NOPLAB/burgerchan/mechanism/clamp.step

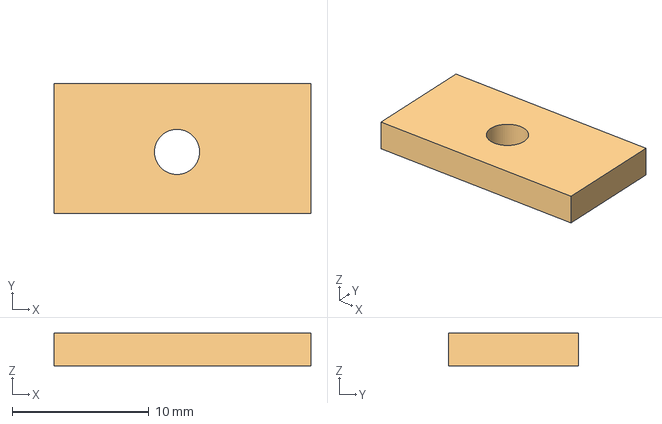
[picture p2: CAD file, 2026-10-23]
mechanism/clamp.step
18.8 x 9.50 x 2.40 mm
