NOPLAB/burgerchan/mechanism/reference/left_tire.stl

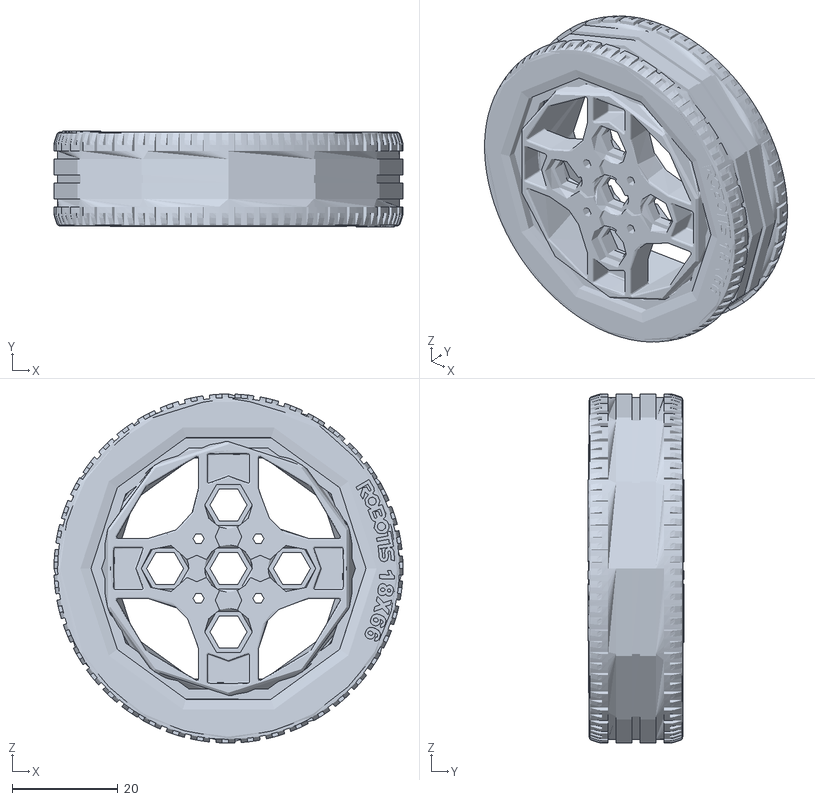
[picture p3: CAD file, 2026-10-23]
mechanism/reference/left_tire.stl
66.0 x 18.2 x 66.0
