NOPLAB/burgerchan/mechanism/carrier.step

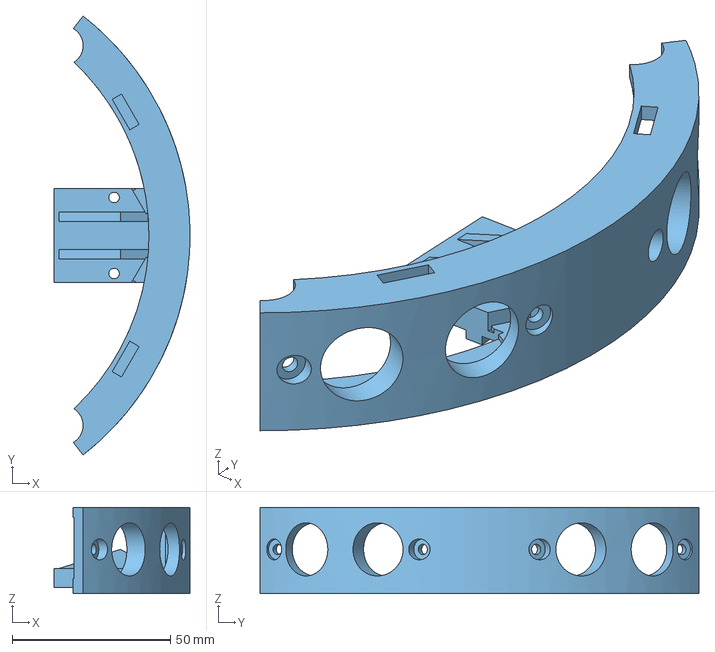
[picture p4: CAD file, 2026-10-23]
mechanism/carrier.step
43.0 x 138.7 x 27.3 mm
