NOPLAB/burgerchan/mechanism/reference/burger_base.stl

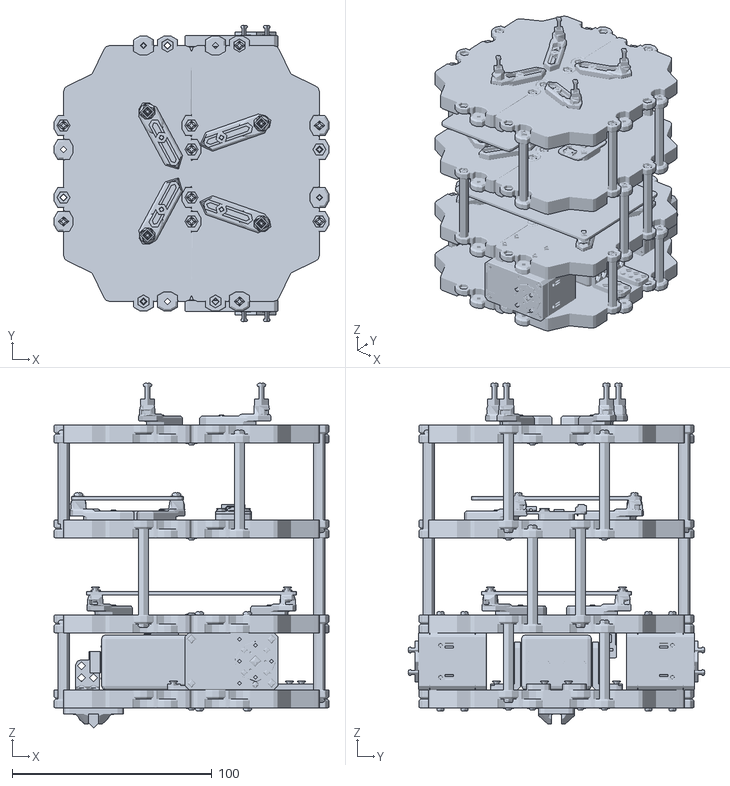
[picture p5: CAD file, 2026-10-23]
mechanism/reference/burger_base.stl
137.5 x 148.3 x 172.6
