NOPLAB/burgerchan/mechanism/reference/tb3_waffle_plate-ipl-01.stp

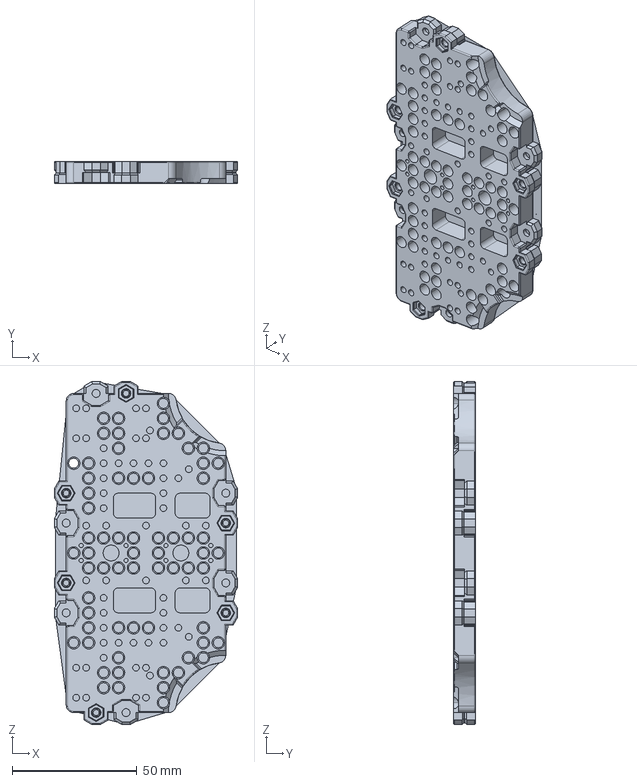
[picture p6: CAD file, 2026-10-23]
mechanism/reference/tb3_waffle_plate-ipl-01.stp
73.5 x 9.00 x 137.5 mm
