NOPLAB/burgerchan/mechanism/reference/mount_master.step

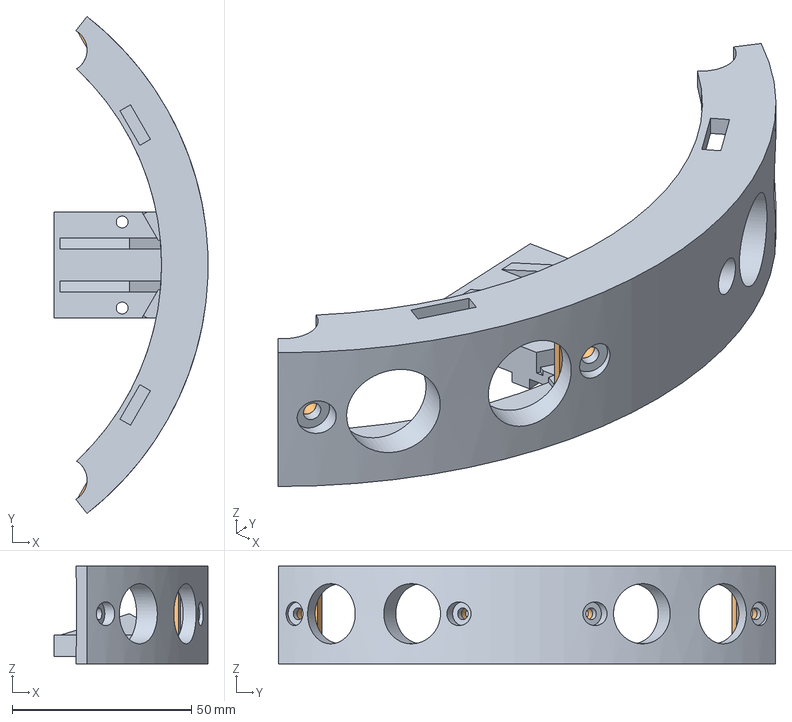
[picture p7: CAD file, 2026-10-23]
mechanism/reference/mount_master.step
42.9 x 138.7 x 27.3 mm
Carrier
LeftInnerClamp
LeftOuterClamp
RightInnerClamp
RightOuterClamp
