NOPLAB/burgerchan/mechanism/reference/lds.stl

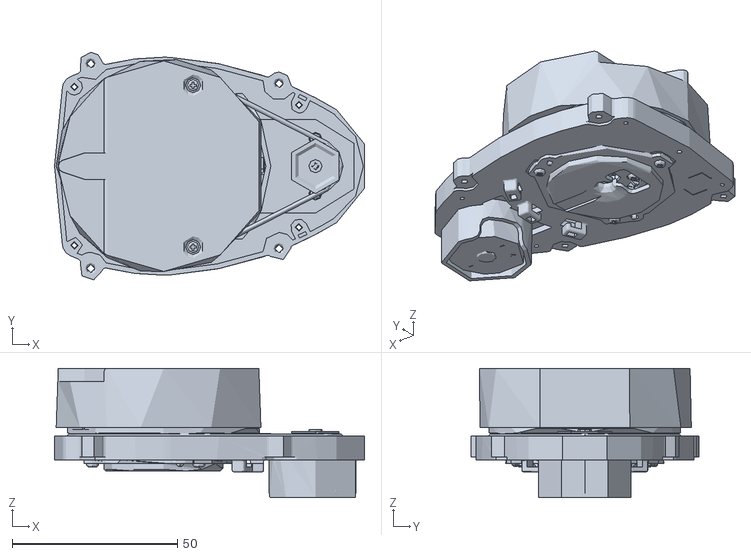
[picture p8: CAD file, 2026-10-23]
mechanism/reference/lds.stl
93.8 x 68.9 x 39.2
