NOPLAB/burgerchan/(list of files, cad)

Other CAD files:
mechanism/reference/right_tire.stl
mechanism/carrier.stl
mechanism/clamp.stl
