NOPLAB/burgerchan/mechanism/verification/assembly_front.png

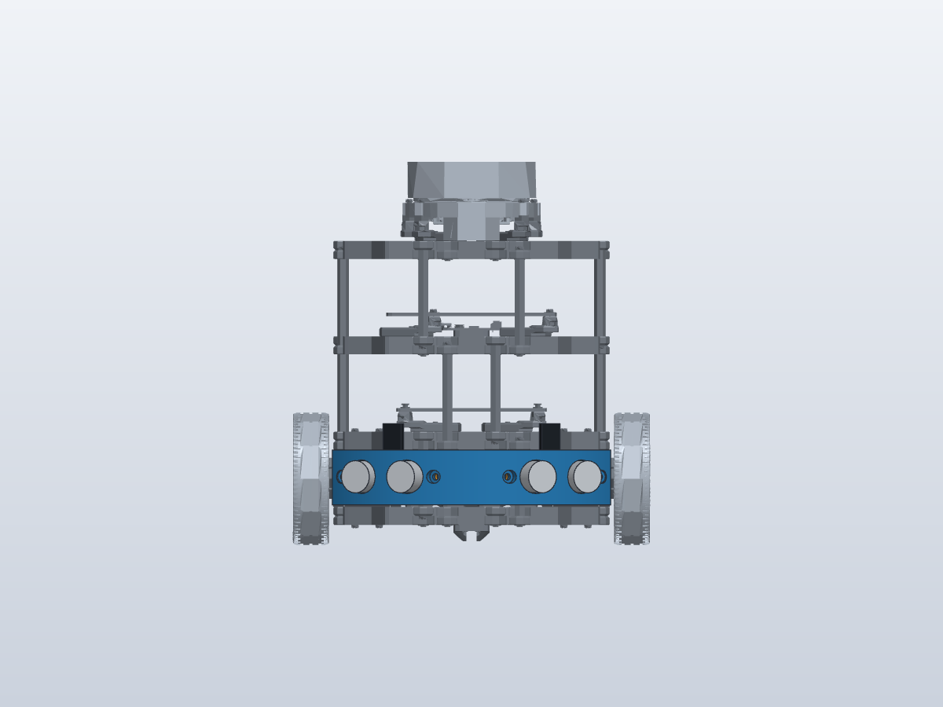
mechanism/verification/assembly_front.png
