NOPLAB/burgerchan/mechanism/verification/assembly_top.png

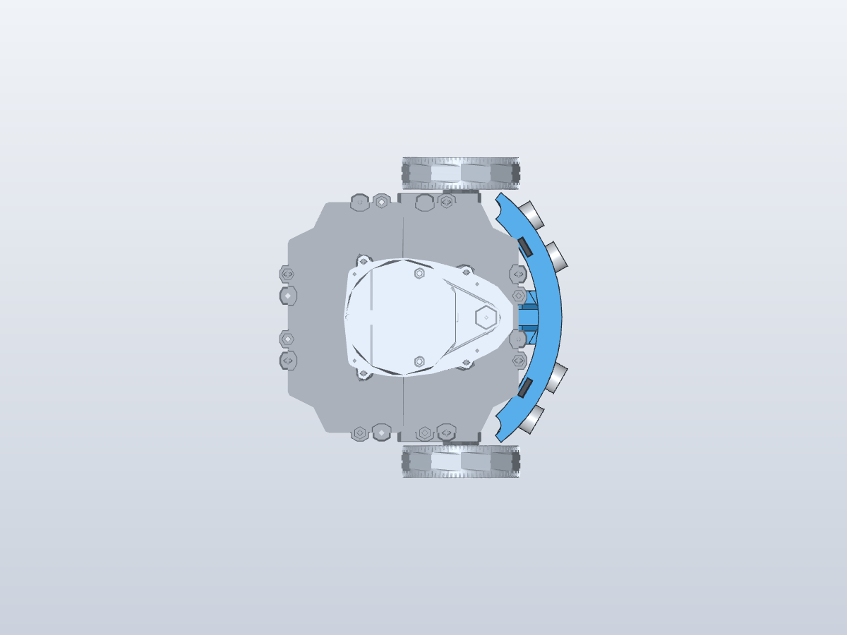
mechanism/verification/assembly_top.png
