NOPLAB/burgerchan/mechanism/verification/carrier_print.png

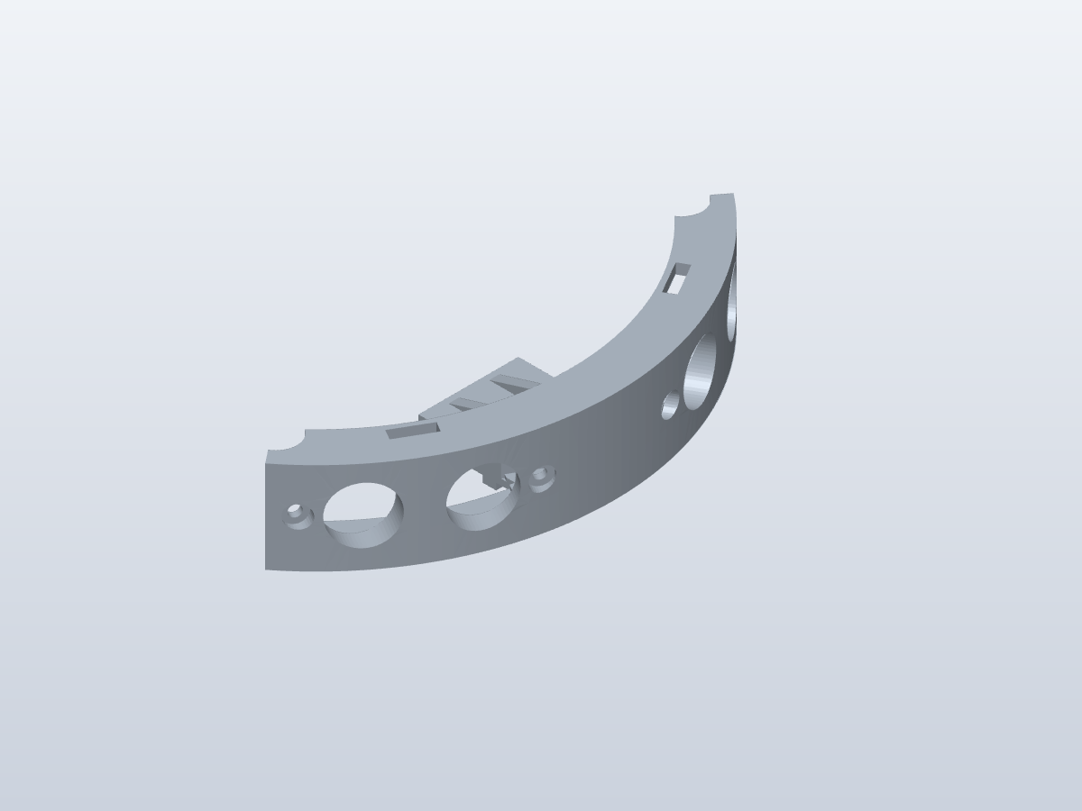
mechanism/verification/carrier_print.png
