NOPLAB/burgerchan/mechanism/verification/clamp_print.png

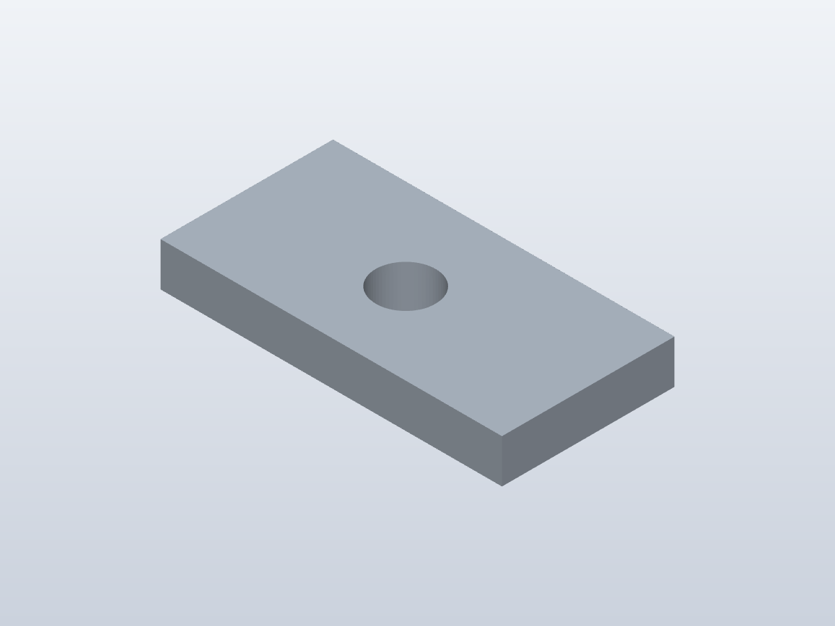
mechanism/verification/clamp_print.png
