NOPLAB/burgerchan/mechanism/verification/mount_top.png

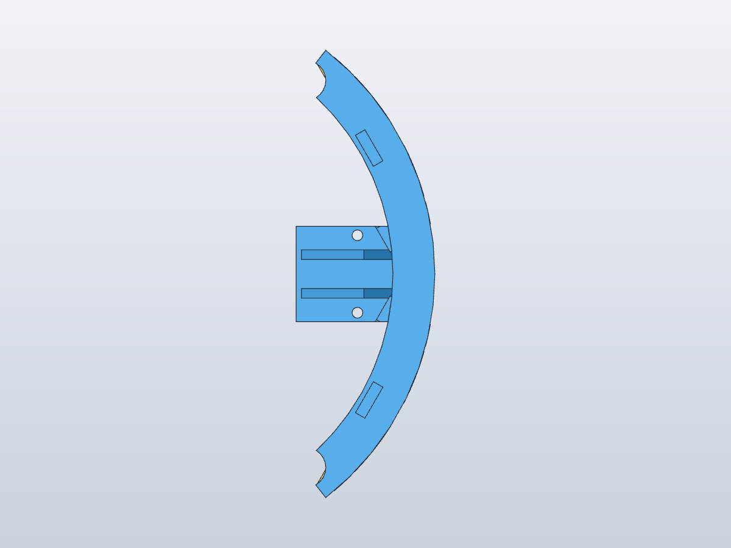
mechanism/verification/mount_top.png
