NOPLAB/burgerchan/(commit log)

2026-10-19 feat(scripts): add TurtleBot3 SBC setup and OpenCR flash scripts
    Set up ROS 2 Humble and turtlebot3_ws on Raspberry Pi 4 (Ubuntu 22.04),
    and flash OpenCR firmware for burger with LDS-01.
2026-10-23 feat(mechanism): add printable ultrasonic sensor mount
    [burger_base.stl, carrier.step, carrier.stl, clamp.step, clamp.stl, lds.stl, left_tire.stl, mount_master.step]
